laurenminer/Waterworks/README.md

All documentation for the Waterworks system can be found in the Waterworks Manual.
