laurenminer/Waterworks/Laser Cutter Files/WaterworksBase_CircuitBoard.pdf

In Out | In Out | In Out | In Out
In Out | In Out | In Out | In Out
In Out | In Out | In Out | In Out
1 | 2 | 3 | 4
5 | 6 | 7 | 8
9 | 10 | 11 | 12

## Waterworks Base

compatible with circuit board base Side Panels
Plastic: 1/8 inch grey acrylic

Color Legend:
- Red: cut
- Black: raster
- Magenta: annotations, do not cut

Power settings for Universal Laser PLS6.150D with 120 watt laser cartridge:
- Red:
- Black:

## Waterworks Base

compatible with circuit board base Base Plate
Plastic: 1/8 inch grey acrylic

Color Legend:
- Red: cut
- Magenta: annotations, do not cut

Power settings for Universal Laser PLS6.150D with 120 watt laser cartridge:
- Red:
