laurenminer/Waterworks/Laser Cutter Files/WaterworksTop.pdf

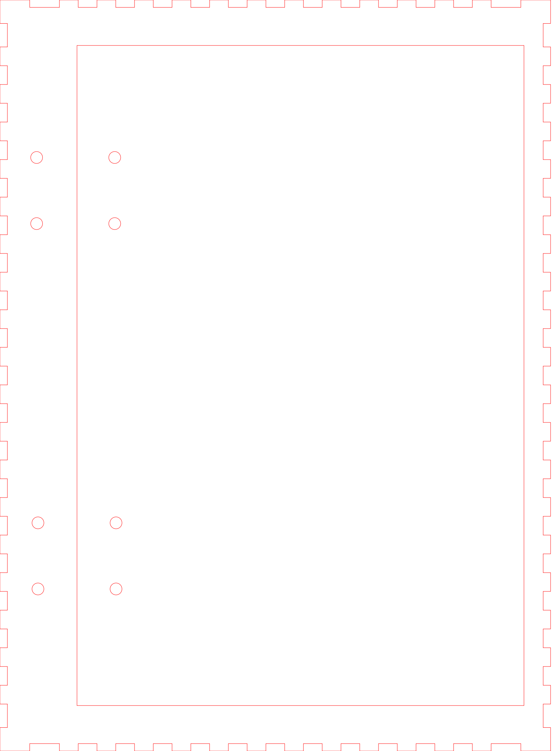
[picture p20: figure]

## Waterworks Top

Front/Door
Plastic: 1/8 inch black acrylic

Color Legend:
- Red: cut
- Magenta: annotations, do not cut

Power settings for Universal Laser PLS6.150D with 120 watt laser cartridge:
- Red:

### 2 Sides

Plastic: 1/8 inch black acrylic

Color Legend:
- Red: cut
- Magenta: annotations, do not cut

Power settings for Universal Laser PLS6.150D with 120 watt laser cartridge:
- Red:

### 1 Side and Top with Camera Hole

Plastic: 1/8 inch black acrylic

Color Legend:
- Red: cut
- Magenta: annotations, do not cut

Power settings for Universal Laser PLS6.150D with 120 watt laser cartridge:
- Red:
