laurenminer/Waterworks/WaterworksParts.xlsx

Sheet: One-Time Purchases
Part Name | Source | Part Name (Manufacturer) | Part Number | Quantity | Price/Unit | Total Cost | Link
Black Wire | Digi-Key | Remmington Industries # 22UL1007STRBLA | 2328-22UL1007STRBLA-ND | 1 | 15.95 | 15.95 | https://www.digikey.com/en/products/detail/remington-industries/22UL1007STRBLA/11613841
Red Wire | Digi-Key | Remmington Industries # 22UL1007STRRED | 2328-22UL1007STRRED-ND | 1 | 15.95 | 15.95 | https://www.digikey.com/en/products/detail/remington-industries/22UL1007STRRED/11615042
Benchtop Solder Smoke Absober | Digi-Key | SRA Soldering Products AO486 | 2260-AO486-ND | 1 | 35.99 | 35.99 | https://www.digikey.com/en/products/detail/sra-soldering-products/AO486/10709947
Light/Magnifer | Digi-Key | Stahl Tools HH3 Magnifying Lamp 374-700 | 2197-374-700-ND | 1 | 46.63 | 46.63 | https://www.digikey.com/en/products/detail/stahl/374-700/10488171
Soldering Stand with Dual Alligator Clips and Magnifying Glass | Digi-Key | Aven Tools 26000 | 243-1018-ND | 1 | 11.68 | 11.68 | https://www.digikey.com/en/products/detail/aven-tools/26000/600972
Solder (Leaded) | Digi-Key | Kester Solder # 24-6337-8800 | KE1400-ND | 1 | 46.75 | 46.75 | https://www.digikey.com/en/products/detail/kester-solder/24-6337-8800/61656
Solder (Lead-Free) | Digi-Key | Kester Solder # 24-7068-7601 | KE1137-ND | 0 | 100.71 | 0 | https://www.digikey.com/en/products/detail/kester-solder/24-7068-7601/738753
Multimeter | Digi-Key | Fluke-117 | 614-1011-ND | 1 | 238.99 | 238.99 | https://www.digikey.com/en/products/detail/fluke-electronics/FLUKE-117/1506333
Wire Stripper and Cutter | Digi-Key | Klein Tools 11057 | 1742-1270-ND | 1 | 28.04 | 28.04 | https://www.digikey.com/en/products/detail/klein-tools-inc/11057/6804879
Soldering iron with tip | Metcal | MFR Single Port System, Soldering Tip | MRF-1120 | 1 | 432 | 432 | https://store.metcal.com/en-us/shop/soldering-desoldering/soldering-desoldering-systems/mfr-series/MFR-1120
Soldering iron tip (only if you need to reorder the tip compatible with the above iron) | Metcal | Hand Piece, Soldering, Tip | MFR-H2-ST2 | 0 | 136 | 0 | https://store.metcal.com/en-us/shop/soldering-desoldering/hand-pieces/MFR-H2-ST2
 |  |  |  |  | 1108.69

Sheet: DigiKey
Part Name (Common) | Part Name (Manufacturer) | Digi-Key Part Number | Quantity | Price/Unit | Total Cost | Link
Female DC Barrel Jack Power Connector | PJ-202A | CP-202A-ND | 1 | 0.6 | 0.6 | https://www.digikey.com/en/products/detail/cui-devices/PJ-202A/252007?s=N4IgTCBcDaIA4CsAEYAMYCCIC6BfIA
Female 7-pin sockets for the buck pucks | PPPC071LFBN-RC | S7040-ND | 36 | 0.532 | 19.152 | https://www.digikey.com/en/products/detail/sullins-connector-solutions/PPPC071LFBN-RC/810179
Screw Terminals: 5 mm pitch and <1 mm pin diameter | 25-E400-02 | 2368-25-E400-ND | 36 | 0.38 | 13.68 | https://www.digikey.com/en/products/detail/cui-devices/TB003-500-P02BE/10064085
Male header for connecting to Arduino (1 x 40) | PREC040SAAN-RC | S1012EC-40-ND | 1 | 0.51 | 0.51 | https://www.digikey.com/en/products/detail/sullins-connector-solutions/PREC040SAAN-RC/2774814
Male header for connecting to the Arduino (2 x 18) | PREC018DAAN-RC | S2012EC-18-ND | 1 | 0.69 | 0.69 | https://www.digikey.com/en/products/detail/sullins-connector-solutions/PREC018DAAN-RC/2774876
Power Strip with 8+ AC Outlets (any will work, example provided) | 1580H10A1 | HM3526-ND | 1 | 82.24 | 82.24 | https://www.digikey.com/en/products/detail/hammond-manufacturing/1580H10A1/2358802
Power Supply | TRH100A120-11E12 VI | 2034-3899-ND | 1 | 49.53 | 49.53 | https://www.digikey.com/en/products/detail/cincon-electronics-co-ltd/TRH100A120-11E12-VI/9685152
Power cord for power supply | 800-18-2-2-STV0-BL-00200-1 | 1175-800-18-2-2-STV0-BL-00200-1-ND | 1 | 9.52 | 9.52 | https://www.digikey.com/en/products/detail/cnc-tech/800-18-2-2-SVT0-BL-00200-1/13420742
 |  |  |  |  | 175.922

Sheet: McMaster-Carr
Part Name | Part Number | Size/Count (if applicable) | Quantity | Price/Unit | Total Cost | Link | Note
1/8” Clear Cast Acrylic Sheet (Grey) | 8505K722 |  | 2 | 15.4 | 30.8 | https://www.mcmaster.com/catalog/127/3896/ | Acrylic for box top
1/8” Acrylic Sheet (Black) | 8505K742 |  | 6 | 15.4 | 92.4 | https://www.mcmaster.com/catalog/127/3896 | Acrylic for box bottom AND chamber
Plastic Hinge with Holes | 1635A22 |  | 2 | 8.61 | 17.22 | https://www.mcmaster.com/catalog/127/3185 | Hinge for box door
Steel Phillips Flat Head Screw* | 90273A245 | 100 ct | 1 | 6.87 | 6.87 | https://www.mcmaster.com/catalog/127/3289/ | Screw for box hinge
18-8 Stainless Steel Narrow Hex Nut* | 90730A011 | 100 ct | 1 | 6.45 | 6.45 | https://www.mcmaster.com/catalog/127/3450 | Nut to secure screw for box hinge
Plastic Barbed Tube Fitting for Air and Water, Tight-Seal,1/8" Tube ID x 10-32 Thread Male Pipe | 5463K53 | 10 ct, White | 3 | 4.49 | 13.47 | https://www.mcmaster.com/catalog/128/194 | Connector to the inner behavioral chamber
Tygon PVC Soft Plastic Tubing for Air and Water, Clear, 1/8" ID, 3/16" OD | 6516T43 | 50 ft | 1 | 20.5 | 20.5 | https://www.mcmaster.com/catalog/128/150 | Tubing from the inner behavioral chamber outward
Plastic Quick-Turn Tube Coupling, Sockets, for 1/8" Barbed Tube ID, Nylon | 51525K213 | 10 ct | 2 | 3.97 | 7.94 | https://www.mcmaster.com/catalog/128/257 | Connector from skinny tubing to stopcock (OUT) | Need 12
Plastic Quick-Turn Tube Coupling, Plugs, for 1/8" Barbed Tube ID, Nylon | 51525K123 | 10 ct | 2 | 4.46 | 8.92 | https://www.mcmaster.com/catalog/128/257 | Connector from stopcock to skinny tubing (IN) | Need 12
Plastic Quick-Turn Tube Coupling, Sockets, for 1/4" Barbed Tube ID, Nylon | 51525K216 | 10 ct | 2 | 4.36 | 8.72 | https://www.mcmaster.com/catalog/128/150/ | Connector between stopcock to main tubing (only used for OUT) | Need 12
Plastic Quick-Turn Tube Coupling, Plugs, for 1/4" Barbed Tube ID, Nylon | 51525K126 | 10 ct | 4 | 5 | 20 | https://www.mcmaster.com/catalog/128/257 | Connector between stopcock to main tubing | Need 24 for IN + 12 for Out = 36
Clear Masterkleer Soft PVC Plastic Tubing for Air and Water, ¼” ID, 3/8” OD | 5233K56 | 100 ft | 1 | 32 | 32 | https://www.mcmaster.com/catalog/127/149 | Main tubing
Wye Connector (10 pk) | 5372K186 | 10 ct | 3 | 17.89 | 53.67 | https://www.mcmaster.com/catalog/127/193 | Y connectors for main tubing
1/16" Clear Acrylic | 8589K12 |  | 2 | 8.81 | 17.62 | https://www.mcmaster.com/catalog/130/4105/8589K12 | Acrylic for chamber
1/8" Clear Acrylic | 8560K257 |  | 2 | 11.06 | 22.12 | https://www.mcmaster.com/catalog/130/4105/8560K257 | Acrylic for chamber
1/4" Clear Acrylic | 8589K82 |  | 1 | 17.6 | 17.6 | https://www.mcmaster.com/catalog/130/4105/8589K82 | Acrylic for chamber
Loctite 587 Gasket Maker Sealant | 7660A21 |  | 1 | 23.42 | 23.42 | https://www.mcmaster.com/catalog/130/3941/7660A21
Plastic Barbed Tube Fitting for Air and Water, Straight Reducer, for 3/8" x 1/4" Tube ID | 5372K517 | 10 ct | 1 | 6.94 | 6.94 | https://www.mcmaster.com/catalog/130/193/5372K517 | Connector between the main tubing and the tubing that fits on the pump
High-Pressure Soft PVC Plastic Tubing for Air and Water, 3/8" ID, 5/8" OD, Clear | 5238K748 | 10 ft | 1 | 14.6 | 14.6 | https://www.mcmaster.com/catalog/130/151/5238K748 | tubing that fits on the adaptor the water pump comes with
 |  |  |  |  | 421.26

Sheet: LED Supply
Part Name | Description | Part Number | Quantity | Price/Unit | Total Cost | Link
Custom 3-Up Luxeon High Power LED | LED #1 = Deep-Red, LED #2 = Green, LED #3 = Blue No jumpers, LEDs Addressable | CUSTOM-3UP-LUXEON | 12 | 19.99 | 239.88 | https://www.ledsupply.com/leds/custom-3-up-luxeon-high-power-led
Carclo Lens | 10507 Carclo Lens – 3-Up Narrow Spot LED Optic | 10507 | 12 | 1.43 | 17.16 | https://www.ledsupply.com/led-optics/10507-carclo-lens-3-up-narrow-spot-led-optic
BuckPuck DC LED Drivers – 700 mA | Connection: 7 pin SIP; Dimming: Dimming (+1.00); Output Current: 700mA | 03021-D-E-700 | 12 | 13.13 | 157.56 | https://www.ledsupply.com/led-drivers/buckpuck-dc-led-drivers
BuckPuck DC LED Drivers – 1000 mA | Connection: 7 pin SIP; Dimming: Dimming (+1.00); Output Current: 1000 mA | 03021-D-E-1000 | 24 | 13.13 | 315.12 | https://www.ledsupply.com/led-drivers/buckpuck-dc-led-drivers
 |  |  |  |  | 729.72

Sheet: Amazon
Part Name | Descriptor/Search Term | Quantity | Price/Unit | Total Cost | Example Link
Aquarium Tubing Clips for Water Bath | Aquarium hose holder with adjustable clamp *must have a clamp wide enough to attach to the side of the water bath | 2 | 10.99 | 10.99 | https://www.amazon.com/Houkr-Aquarium-Adjustable-Multifunction-Water-Change/dp/B087M3PT2T
Aquarium Tubing Clips for Water Resevior | Fish tank hose holder hanger | 2 | 10.85 | 10.85 | https://www.amazon.com/MiguCo-Water-Mounting-Aquarium-Holder/dp/B07WWLF783
Room Temperature Water Reservior | Rubbermaid Ice Bin 12.1" x 5.5" x 6.12" | 1 | 12 | 12 | https://www.amazon.com/Rubbermaid-Ice-Bin-12-1-6-12/dp/B0010L1C28
Water Pump | EcoPlus 728300 Pump, 158 GPH, Black | 2 | 19.78 | 39.56 | https://www.amazon.com/EcoPlus-Submersible-Aquarium-Fountain-Hydroponics/dp/B0018WVNXC
Raspberry Pi | Raspberry Pi 3 Model B Motherboard | 1 | 43.99 | 43.99 | https://www.amazon.com/Raspberry-Pi-MS-004-00000024-Model-Board/dp/B01LPLPBS8
Power Supply for the Raspberry Pi | Ex. CanaKit 5V 2.5A Raspberry Pi 3 B+ Power Supply/Adapter | 1 | 9.95 | 9.95 | https://www.amazon.com/CanaKit-Raspberry-Supply-Adapter-Listed/dp/B00MARDJZ4
Raspberry Pi Camera | Raspberry Pi Camera Module V2-8 Megapixel,1080p (RPI-CAM-V2) | 1 | 23.81 | 23.81 | https://www.amazon.com/Raspberry-Pi-Camera-Module-Megapixel/dp/B01ER2SKFS
Micro SD Card | SAMSUNG (MB-ME32GA/AM) 32GB 95MB/s (U1) microSDHC EVO Select Memory Card with Full-Size Adapter | 1 | 14.99 | 14.99 | https://www.amazon.com/Samsung-MicroSDHC-Adapter-MB-ME32GA-AM/dp/B06XWN9Q99
Desktop Monitor | Ex. PHILIPS 22 inch Class Thin Full HD (1920 x 1080) 75Hz Monitor, VESA, HDMI & VGA Port, 4 Year Advance Replacement Warranty, 221V8LN | 1 | 69.99 | 69.99 | https://www.amazon.com/PHILIPS-Computer-Monitors-Replacement-221V8LN/dp/B0BRR4ZGNP?th=1
HDMI Cord | Ex. Amazon Basics CL3 Rated High-Speed HDMI Cable (18 Gbps, 4K/60Hz) - 3 Feet, Pack of 2, Black | 1 | 9.81 | 9.81 | https://www.amazon.com/AmazonBasics-High-Speed-HDMI-Cable-2-Pack/dp/B014I8SP4W
IR Lights | Ex. Phenas Home 48-led CCTV Ir Infrared Night Vision Illuminator Camera LEDs Lamp | 2 | 15.8 | 31.6 | https://www.amazon.com/Phenas-48-led-Infrared-Vision-Illuminator/dp/B00GFDAJEI
AC/DC Adaptor 12V Power Supply | Ex. 12V Power Supply 7A 84W Security System Power Adapter, COOLM AC 100V-220V to DC 12 Volt DC 7 Amp Transformer for LED Strip Light CCTV Security System | 1 | 16.69 | 16.69 | https://www.amazon.com/COOLM-Power-Adapter-100-240V-Output/dp/B07BVPJBCW
1 to 2 Way DC Power Splitter | Ex. 2Pack 1 to 2 Way DC Power Splitter Cable Barrel Plug 5.5mm x 2.1mm for CCTV Cameras LED Light Strip and more | 1 | 6.12 | 6.12 | https://www.amazon.com/2Pack-Power-Splitter-Barrel-Cameras/dp/B01M7N1GOH
Pi to Arduino Connector | Ex. Mediabridge USB 2.0 - A Male to B Male Cable (6 Feet) - High-Speed with Gold-Plated Connectors - Black - (Part# 30-001-06B) | 1 | 5.84 | 5.84 | https://www.amazon.com/Mediabridge-USB-2-0-High-Speed-Gold-Plated/dp/B001MXLD4G
37mm IR 850 Fliter | Ex. Gzikai 37mm IR 850 Glass Infrared X-Ray Filter 850nm IR Filter for Camera Lens Digital DSLR SLR | 1 | 17.99 | 17.99 | https://www.amazon.com/Gzikai-Infrared-Filter-Camera-Digital/dp/B0CL272KM7?th=1
3D Printing Filament | Ex. HATCHBOX Matte PLA 3D Printer Filament, Dimensional Accuracy +/- 0.03 mm, 1 kg Spool, 1.75 mm, Black | 1 | 25.99 | 25.99 | https://www.amazon.com/HATCHBOX-Printer-Filament-Dimensional-Accuracy/dp/B09G7BXN2J
Set of Small Screwdrivers | Ex. 11-Piece Precision Screwdriver Set - Magnetic Mini Screwdrivers for Eyeglasses, Watches, Computers, Laptops, Phones - Phillips, Slotted, Torx, Non-Slip Handle, Portable Storage Bag Included | 1 | 11.5 | 11.5 | https://www.amazon.com/SEDY-Precision-Screwdriver-Magnetic-Screwdrivers/dp/B0B2NN9J6K
Absorbent Pads | Ex. Amazon Basics Dog and Puppy Pee Pads with Leak-Proof Quick-Dry Design for Potty Training, Heavy Duty Absorbency, Regular Size, 24 x 23 Inches, Pack of 50, Blue & White | 1 | 21.76 | 21.76 | https://www.amazon.com/Amazon-Basics-Absorbency-Leak-proof-Quick-dry/dp/B07CWD5PX5
Absorbent Cloths | Ex. Sophia's Secret Microfiber Cleaning Cloth - Multipurpose Reusable Kitchen Cloth - Highly Absorbent Lint Free Microfiber Dusting Cloth Rags for Car, House, Window - 8- 12x16, Pack of 8 | 1 | 12.99 | 12.99 | https://www.amazon.com/gp/product/B093KTHD3J/ref=ppx_yo_dt_b_search_asin_title?ie=UTF8&psc=1
Hot Glue Gun Kit | Assark Glue Gun, Mini Hot Glue Gun Kit with 30 Glue Sticks for School Crafts DIY Arts Quick Home Repairs, 20W (Blue) | 1 | 8.99 | 8.99 | https://www.amazon.com/Assark-Sticks-School-Repairs-20W/dp/B09FYWQ44L
Tacky Glue | All-Purpose Tacky Glue – Premium Adhesive for Crafts, Hobbies, and Household Repairs (1 Pack) | 1 | 8.99 | 8.99 | https://www.amazon.com/All-Purpose-Tacky-Metal-Glue-Household/dp/B0CLW5NZTR?th=1
Fast Orange Hand Cleaner | Ex. Permatex Fast Orange Fine Pumice Lotion Hand Cleaner | 1 | 9.71 | 9.71 | https://www.amazon.com/Permatex-Orange-Pumice-Lotion-Cleaner/dp/B07H3CCLJ4
Keyboard | Ex. Amazon Basics Low-Profile Wired USB Keyboard with US Layout | 1 | 13.94 | 13.94 | https://www.amazon.com/AmazonBasics-Matte-Keyboard-QWERTY-Layout/dp/B07WJ5D3H4
Mouse | Ex. Amazon Basics 3-Button Wired USB Computer Mouse, Single, Black | 1 | 7.19 | 7.19 | https://www.amazon.com/AmazonBasics-3-Button-Wired-Computer-1-Pack/dp/B005EJH6RW?th=1
Ethernet net | Ex. Amazon Basics RJ45 Cat 6 Ethernet Patch Cable, 1Gpbs Transfer Speed, Gold-Plated Connectors, 3 Foot For PC, TV, tablet, router, printer | 1 | 3.97 | 3.97 | https://www.amazon.com/Amazon-Basics-Ethernet-Gold-Plated-Connectors/dp/B00N2VISLW?th=1
Wooden blocks | Ex. Solid Hard Wood Blocks- 5 1/4 Inches Long by 2 Inches Wide - Pack of 6 by Sustainable Things | 1 | 19.99 | 19.99 | https://www.amazon.com/Solid-Hard-Wood-Blocks-Inches/dp/B019M1W9YM
Multicolor washi tape | Ex. 30 Rolls Washi Masking Tape Set, 15mm Wide Colorful Rainbow, Decorative Writable Craft Tape for DIY Scrapbook Designs | 1 | 9.97 | 9.97 | https://www.amazon.com/Masking-Colorful-Decorative-Tape%EF%BC%8CDecorative-Writable/dp/B07GBSFXC9
 |  |  |  | 479.17

Sheet: Misc.
Part Name | Store | Part Number | Quantity | Price/Unit | Total Cost | Link | Alternate Link
Arduino Mega 2560 Rev3 | Arduino Store | Code: A000067 Barcode: 7630049200067 | 1 | 40.30 | 40.30 | https://store.arduino.cc/usa/mega-2560-r3
Water Bath | PolyScience | 5 L General Purpose Water Bath, Digital # WBE05 | 1 | 604.75 | 604.75 | https://www.polyscience.com/general-purpose-water-baths/5-liter-general-purpose-water-bath
Water Bath Cleaner | PolyScience | PolyScience Polyclear Clarifier | 1 | 44.00 | 44.00 | https://www.polyscience.com/fluidaccessories/polyclean-clarifier-8-oz-case-12-x-8-oz
3-way Stopcock with Swivel Male Leur Lock (50 ct) Smiths Medical Mx5311L | Fisher Scientific | NC9779127 | 1 | 61.21 | 61.21 | https://www.fishersci.com/shop/products/3-way-stop-cock-50-cs3-way-st/NC9779127
1-way stopcock with male and female leur lock | FisherScientific | Ex. Qosina Corp 99759 (aka FisherScientific NC1503539) | 1 | 19.18 | 19.18 | https://www.fishersci.com/shop/products/1-way-stopcock-female-luer-lo/NC1503539
3D Printer | LulzBot | LulzBot Taz Workhorse | 1 | 2950 | 2950 | https://lulzbot.com/store/lulzbot-3d-printer-taz-workhorse-boxed-for-retail-na-kt-pr0051na
Plastic Tray for Support (or use the cardboard that the fly food comes in) | Amazon | iDesign Decorative Countertop Vanity Tray Organizer for Bathroom, Bedroom, Closet, Entryway, The Clarity Collection – 8" x 8" x 2", Clear | 1 | 11.5 | 11.5 | https://www.amazon.com/InterDesign-Clarity-Cosmetic-Organizer-Products/dp/B012SBZ1EI
 |  |  |  |  | 3730.94
