laurenminer/Waterworks/waterworks_columns.stl

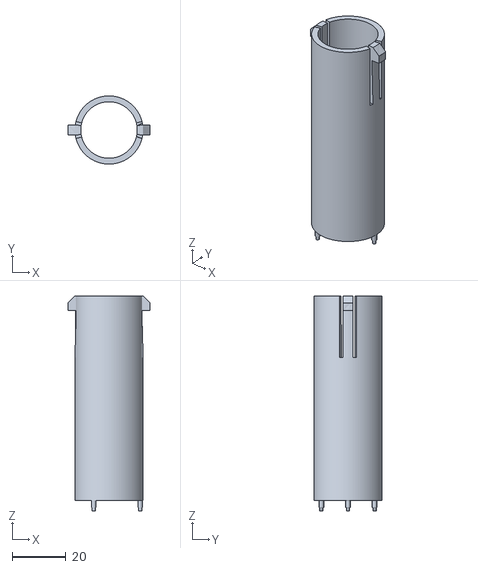
[picture p29: CAD file, 2024-01-30]
waterworks_columns.stl
30.6 x 25.4 x 80.0
