laurenminer/Waterworks/door_handle.stl

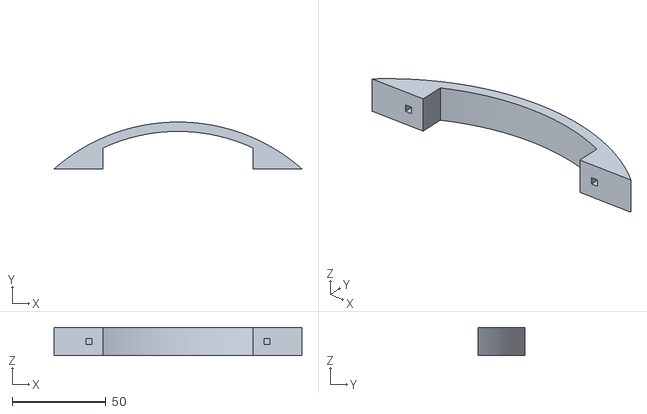
[picture p30: CAD file, 2024-01-30]
door_handle.stl
132.3 x 25.0 x 15.0
